FarmteK/BasicAutoSteerPCB/README.md

# BasicAutoSteerPCB

Repository of Eagle schematic and board. Parts list spreadsheet that can be imported into DigiKey's BOM and Cart interface. 

The Eagle files are in v7. Gerber and Drill files made by version 9.1.3

Board is roughly 100mm x 127mm or 4x5 inches.
