FarmteK/BasicAutoSteerPCB/AutoSteerPCB/PartsList.xlsx

Manufacturer Part Number | Manufacturer | Digi-Key Part Number | Customer Reference | Quantity | Unit Price | Extended Price | Description
VX7805-1000 | CUI Inc. | 102-4253-ND |  | 2 | $4.70 | $9.40 | DC DC CONVERTER 5V 5W
15159B | Essentra Components | RPC5587-ND |  | 1 | $1.24 | $1.24 | BLANKING PLUG: .610 IN (15.5 MM)
E1003S.41.10 | General Cable/Carol Brand | CE1003SG-50-ND |  | 1 | $18.35 | $18.35 | CABLE 3COND 22AWG GRAY 50'
1455N1602 | Hammond Manufacturing | HM980-ND |  | 1 | $27.04 | $27.04 | BOX ALUM NATURAL 6.3"LX4.06"W
C320C104J5R5TA7301 | KEMET | 399-9867-1-ND |  | 10 | $0.45 | $4.50 | CAP CER 0.1UF 50V X7R RADIAL
LTL42EKEKNN | Lite-On Inc. | 160-1665-ND |  | 2 | $0.68 | $1.36 | LED RED CLEAR T-1 T/H
M2011LL1W01 | NKK Switches | 360-3287-ND |  | 1 | $7.33 | $7.33 | SWITCH TOGGLE SPST 6A 125V
1N5401RLG | ON Semiconductor | 1N5401RLGOSCT-ND |  | 2 | $0.60 | $1.20 | DIODE GEN PURP 100V 3A DO201AD
1N4004RLG | ON Semiconductor | 1N4004RLGOSCT-ND |  | 4 | $0.28 | $1.12 | DIODE GEN PURP 400V 1A DO41
CB1-P-12V | Panasonic Electric Works | 255-1832-ND |  | 2 | $7.80 | $15.60 | RELAY AUTOMOTIVE SPDT 40A 12V
110-87-306-41-001101 | Preci-Dip | 1212-1002-ND |  | 4 | $0.58 | $2.32 | CONN IC DIP SOCKET 6POS GOLD
35PX1000MEFC10X20 | Rubycon | 1189-1745-ND |  | 4 | $1.04 | $4.16 | CAP ALUM 1000UF 20% 35V RADIAL
108070021 | Seeed Technology Co., Ltd | 1597-1593-ND |  | 1 | $15.26 | $15.26 | MD13S CYTRON 13AMP DC MOTOR DRIV
CF14JT330R | Stackpole Electronics Inc | CF14JT330RCT-ND |  | 15 | $0.06 | $0.90 | RES 330 OHM 1/4W 5% AXIAL
CF14JT1K00 | Stackpole Electronics Inc | CF14JT1K00CT-ND |  | 15 | $0.06 | $0.90 | RES 1K OHM 1/4W 5% AXIAL
5-535541-8 | TE Connectivity AMP Connectors | A32922-ND |  | 1 | $3.26 | $3.26 | CONN RCPT 10POS 0.1 GOLD PCB
5-535541-4 | TE Connectivity AMP Connectors | A32920-ND |  | 1 | $3.06 | $3.06 | CONN RCPT 6POS 0.1 GOLD PCB
1-534237-3 | TE Connectivity AMP Connectors | A26425-ND |  | 2 | $3.79 | $7.58 | CONN RCPT 15POS 0.1 GOLD PCB
282834-3 | TE Connectivity AMP Connectors | A98334-ND |  | 4 | $2.85 | $11.40 | TERM BLK 3P SIDE ENT 2.54MM PCB
282834-4 | TE Connectivity AMP Connectors | A98335-ND |  | 3 | $3.80 | $11.40 | TERM BLK 4P SIDE ENT 2.54MM PCB
282834-7 | TE Connectivity AMP Connectors | A135912-ND |  | 1 | $9.38 | $9.38 | TERM BLK 7P SIDE ENT 2.54MM PCB
282857-3 | TE Connectivity AMP Connectors | A98360-ND |  | 4 | $2.43 | $9.72 | TERM BLK 3P SIDE ENT 5.08MM PCB
282857-2 | TE Connectivity AMP Connectors | A98359-ND |  | 2 | $1.87 | $3.74 | TERM BLK 2P SIDE ENT 5.08MM PCB
4N33 | Vishay Semiconductor Opto Division | 4N33VS-ND |  | 4 | $0.92 | $3.68 | OPTOISO 5.3KV DARL W/BASE 6DIP
61304011121 | Wurth Electronics Inc. | 732-5334-ND |  | 2 | $2.04 | $4.08 | CONN HEADER VERT 40POS 2.54MM
CB1AF-12V | Panasonic Electric Works | 255-2172-ND |  | 1 | $7.29 | $7.29 | RELAY AUTOMOTIVE SPST 40A 12V
VCF4-1000 | TE Connectivity Potter & Brumfield Relays | PB232-ND |  | 1 | $3.38 | $3.38 | RELAY SOCKET 5 POS THROUGH HOLE
Non Digikey Specific
MMA8452Q 3.3V - BOB-13926 | Sparkfun | xx |  | 1 | $8.00 | $8.00 | MMA8452Q Breakout Board
 |  |  |  |  |  |  | https://www.sparkfun.com/products/13926
ADS1115 - 16 bit A/D convertor | AdaFruit, Ebay, Amazon | xx |  | 1 | $12.00 | $12.00 | 16 bit A/D convertor on BO board
 |  |  |  |  |  |  | https://www.adafruit.com/product/1085
Arduino Nano v3 | Arduino (EBAY, Amazon) | xx |  | 1 | $28.50 | $28.50 | ARDUINO NANO ATMEGA328 v3
 |  |  |  |  |  |  | https://www.ebay.ca/i/262445926219?chn=ps&mkevt=1&mkrid=706-89093-2056-0&mkcid=2&dispItem=1
ENC28J60 - Ethernet Module | WorldChips |  |  | 1 | $7.00 | $7.00 | Mini ENC28J60 Webserver module Ethernet Shield board for Arduino Nano v3.0 top
 |  |  |  |  |  |  | https://www.ebay.ca/itm/Mini-ENC28J60-Webserver-module-Ethernet-Shield-board-for-Arduino-Nano-v3-0-top/221629702393
DC Gear Motor - 3269_3 | Phidgets | xx |  |  | $69.00 | $69.00 | 24V/5.1Kg-cm/588RPM 4.25:1 DC Gear Motor
 |  |  |  |  |  |  | https://www.phidgets.com/?&prodid=299
XW-12-24-240W | Various (EBAY) | xx |  |  | $25.00 | $25.00 | 12 v to 24 v convertor - min 10A
 |  |  |  |  |  |  | https://www.ebay.ca/itm/Waterproof-Aluminum-12V-to-24V-DC-DC-Step-Up-Power-Supply-Converter-10A-240W/192404024654
Proximity Switch - LJ12A3-4-Z/BY | Various - (EBAY, Amazon) | xx |  | 1 | $12.00 | $12.00 | Proximity Switch N.O. 4mm
 |  |  |  |  |  |  | https://www.amazon.ca/Detecting-Distance-Inductive-Proximity-LJ12A3-4-Z/dp/B00DUYSWXK
