FarmteK/BasicAutoSteerPCB/RelayAndSwitchPCB/RelaySwitchPCB_Parts.xlsx

Index | Quantity | Part Number | Manufacturer Part Number | Description | Customer Reference | Available | Backorder | Unit Price | Extended Price CAD
1 | 1 | 102-4253-ND | VX7805-1000 | DC DC CONVERTER 5V 5W |  | 1 | 0 | 4.7 | 4.70
2 | 1 | CE1003SG-50-ND | E1003S.41.10 | CABLE 3COND 22AWG GRAY 50' |  | 1 | 0 | 18.35 | 18.35
3 | 10 | 399-9867-1-ND | C320C104J5R5TA7301 | CAP CER 0.1UF 50V X7R RADIAL |  | 10 | 0 | 0.45 | 4.50
4 | 2 | 160-1665-ND | LTL42EKEKNN | LED RED CLEAR T-1 T/H |  | 2 | 0 | 0.68 | 1.36
5 | 2 | 1N5401RLGOSCT-ND | 1N5401RLG | DIODE GEN PURP 100V 3A DO201AD |  | 2 | 0 | 0.6 | 1.20
6 | 2 | 1189-1745-ND | 35PX1000MEFC10X20 | CAP ALUM 1000UF 20% 35V RADIAL |  | 2 | 0 | 1.04 | 2.08
7 | 15 | CF14JT1K00CT-ND | CF14JT1K00 | RES 1K OHM 1/4W 5% AXIAL |  | 15 | 0 | 0.06 | 0.90
8 | 4 | A98335-ND | 282834-4 | TERM BLK 4P SIDE ENT 2.54MM PCB |  | 4 | 0 | 3.8 | 15.20
9 | 3 | A98360-ND | 282857-3 | TERM BLK 3P SIDE ENT 5.08MM PCB |  | 3 | 0 | 2.43 | 7.29
10 | 10 | CF14JT10K0CT-ND | CF14JT10K0 | RES 10K OHM 1/4W 5% AXIAL |  | 10 | 0 | 0.06 | 0.60
11 | 2 | 497-2356-5-ND | ULN2803A | TRANS 8NPN DARL 50V 0.5A 18DIP |  | 2 | 0 | 1.69 | 3.38
12 | 1 | MCP23017-E/SP-ND | MCP23017-E/SP | IC I/O EXPANDER I2C 16B 28SDIP |  | 1 | 0 | 1.87 | 1.87
13 | 2 | AE10918-ND | AR-18-HZL/01-TT | CONN IC DIP SOCKET 18POS GOLD |  | 2 | 0 | 2.01 | 4.02
14 | 1 | AE10029-ND | AR 28 HZL/01/7-TT | CONN IC DIP SOCKET 28POS GOLD |  | 1 | 0 | 3.6 | 3.60
15 | 10 | A98334-ND | 282834-3 | TERM BLK 3P SIDE ENT 2.54MM PCB |  | 10 | 0 | 2.16 | 21.60
16 | 8 | 255-2591-ND | ACT112 | RELAY AUTOMOTIVE SPDT 20A 12V |  | 8 | 0 | 4.26 | 34.08
17 | 10 | CF14JT4K70CT-ND | CF14JT4K70 | RES 4.7K OHM 1/4W 5% AXIAL |  | 10 | 0 | 0.06 | 0.60
