FarmteK/BasicAutoSteerPCB/AutoSteerPCB/diyAutoSteer.brd

## EAGLE design AutoSteerPCB/diyAutoSteer.brd (2019-06-20)

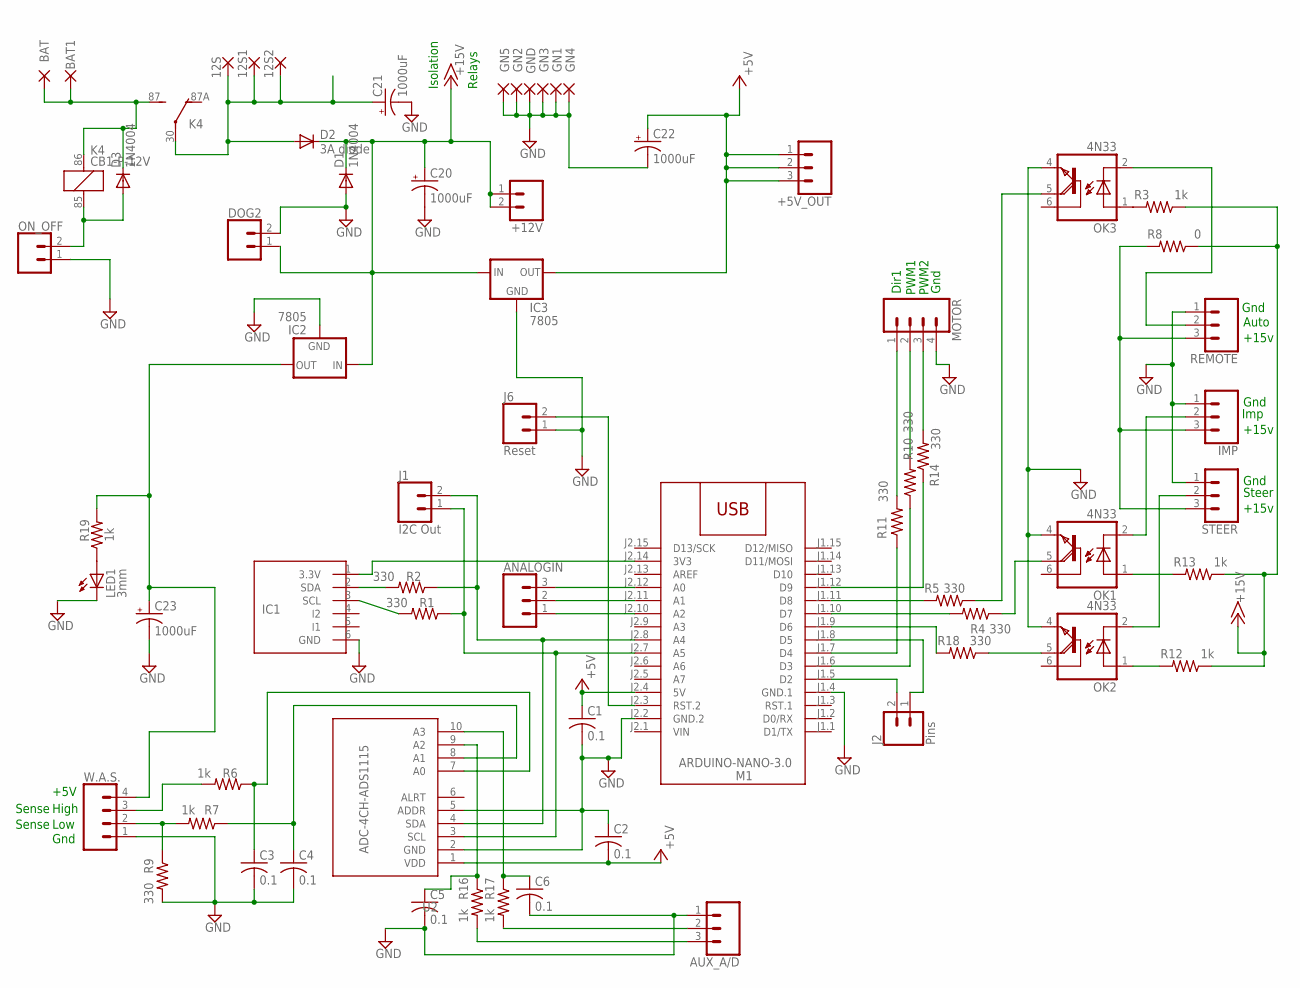
[picture p1: schematic diyAutoSteer.sch]

Parts:
12S, 12S1, 12S2: WIREPAD3,81/1,1; 3,81/1,1
+5V_OUT: CONN_03LONGPADS; 1X03_LONGPADS
+12V: CONN_02PTH3; 1X02_LONGPADS
ANALOGIN: CONN_03LONGPADS; 1X03_LONGPADS
AUX_A/D: CONN_03LONGPADS; 1X03_LONGPADS
BAT, BAT1: WIREPAD3,81/1,1; 3,81/1,1
C1, C2, C3, C4, C5, C6: 0.1; C025-025X050
C20, C21, C22, C23: 1000uF; E5-10,5
D1, D3: 1N4004; DO41-10
D2: 3A diode; DO27-15
DOG2: CONN_02PTH3; 1X02_LONGPADS
GN1, GN2, GN3, GN4, GN5: WIREPAD3,81/1,1; 3,81/1,1
GND: WIREPAD3,81/1,1; 3,81/1,1
IC1: MMA8452Q; BREAKOUT_6PIN
IC2, IC3: 7805; 78XXS
IMP: CONN_03LONGPADS; 1X03_LONGPADS
J1: I2C Out; 1X02_LONGPADS
J2: Pins; 1X02_LONGPADS
J6: Reset; 1X02_LONGPADS
K4: CB1-P-12V; CB1
LED1: 3mm; LED3MM
M1: ARDUINO-NANO-3.0
MOTOR: CONN_04LONGPADS; 1X04_LONGPADS
OK1, OK2, OK3: 4N33; DIL06
ON_OFF: CONN_02PTH3; 1X02_LONGPADS
R1, R2, R4, R5, R9, R10, R11, R14, R18: 330; 0309/12
R3, R6, R7, R12, R13, R16, R17, R19: 1k; 0309/12
R8: 0; 0309/12
REMOTE: CONN_03LONGPADS; 1X03_LONGPADS
STEER: CONN_03LONGPADS; 1X03_LONGPADS
U2: ADC-4CH-ADS1115
W.A.S.: CONN_04LONGPADS; 1X04_LONGPADS

Connections:
+5V: +5V_OUT.1, +5V_OUT.2, +5V_OUT.3, C1.1, C2.2, C22.+, IC3.OUT, M1.J2.4 (5V), U2.1 (VDD)
+15V: +12V.1, +12V.2, C20.+, D1.C, D2.C, DOG2.1, IC2.IN, IC3.IN, R3.1, R8.1, R12.1, R13.1
BATT: BAT.1, BAT1.1, D3.C, K4.86 (1), K4.87 (S)
GND: AUX_A/D.1, C1.2, C2.1, C3.2, C4.2, C5.2, C6.2, C20.-, C21.-, C22.-, C23.-, D1.A, DOG2.2, GN1.1, GN2.1, GN3.1, GN4.1, GN5.1, GND.1, IC1.6 (GND), IC2.GND, IC3.GND, IMP.1, J6.1, LED1.K (C), M1.J1.4 (GND.1), M1.J2.2 (GND.2), MOTOR.4, OK1.4 (E), OK2.4 (E), OK3.4 (E), ON_OFF.1, R9.2, REMOTE.1, STEER.1, U2.2 (GND), U2.5 (ADDR), W.A.S..1
unnamed: IC1.1 (3.3V), M1.J2.14 (3V3)
unnamed: R7.2, R9.1, W.A.S..2
unnamed: IMP.3, R8.2, REMOTE.3, STEER.3
unnamed: M1.J1.6 (D3), R10.1
unnamed: M1.J1.7 (D4), R11.1
unnamed: J2.2, M1.J1.5 (D2)
unnamed: J6.2, M1.J2.3 (RST.2)
unnamed: R6.2, W.A.S..3
unnamed: ANALOGIN.3, M1.J2.12 (A0)
unnamed: M1.J1.12 (D9), R14.1
unnamed: IC1.2 (SDA), R2.2
unnamed: IC1.3 (SCL), R1.2
unnamed: ANALOGIN.2, M1.J2.11 (A1)
unnamed: ANALOGIN.1, M1.J2.10 (A2)
unnamed: LED1.A, R19.1
unnamed: MOTOR.2, R10.2
unnamed: J2.1, M1.J1.8 (D5)
unnamed: MOTOR.1, R11.2
unnamed: C3.1, R6.1, U2.7 (A0)
unnamed: MOTOR.3, R14.2
unnamed: OK2.2 (C), STEER.2
unnamed: M1.J1.11 (D8), R5.2
unnamed: D3.A, K4.85 (2), ON_OFF.2
unnamed: OK2.1 (A), R12.2
unnamed: OK3.1 (A), R3.2
unnamed: M1.J1.10 (D7), R4.2
unnamed: OK3.2 (C), REMOTE.2
unnamed: IMP.2, OK1.2 (C)
unnamed: M1.J1.9 (D6), R18.2
unnamed: OK1.1 (A), R13.2
unnamed: OK3.5 (COL), R5.1
unnamed: C6.1, R17.1, U2.10 (A3)
unnamed: C5.1, R16.1, U2.9 (A2)
unnamed: OK1.5 (COL), R4.1
unnamed: AUX_A/D.2, R17.2
unnamed: OK2.5 (COL), R18.1
unnamed: C4.1, R7.1, U2.8 (A1)
unnamed: AUX_A/D.3, R16.2
SCL: J1.1, M1.J2.7 (A5), R1.1, U2.3 (SCL)
SDA: J1.2, M1.J2.8 (A4), R2.1, U2.4 (SDA)
SW_RAW: 12S.1, 12S1.1, 12S2.1, C21.+, D2.A, K4.30
V+WAS: C23.+, IC2.OUT, R19.2, W.A.S..4
VIN: M1.J2.1 (VIN)

Notes on the sheet:
Gnd
Low
High
+5V
PWM1
PWM2
Dir1
Steer
Imp
Sense
Auto
Isolation
Relays
+15v

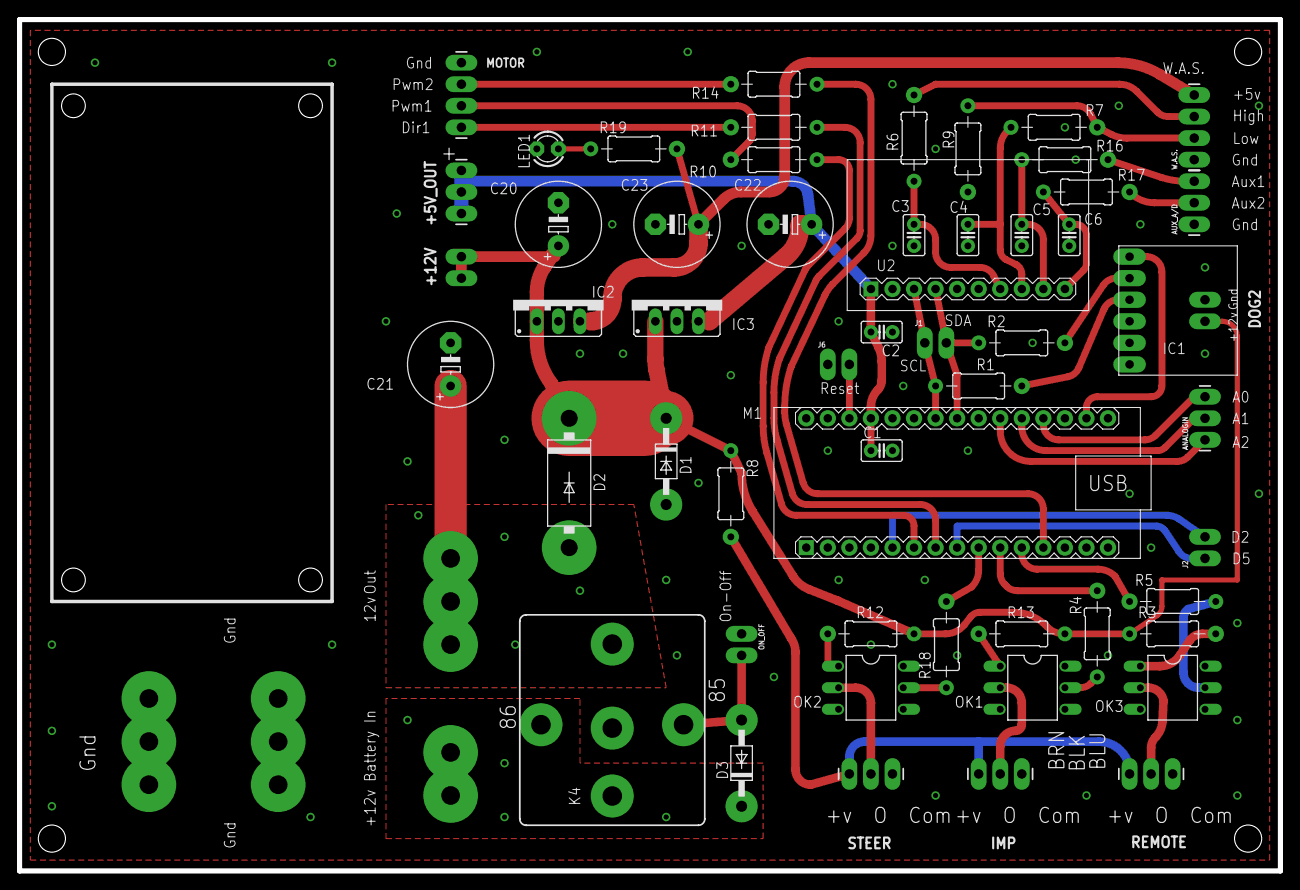
[picture p2: board diyAutoSteer.brd from above]

Board: 2 copper layers, 148.6 x 100.3 mm, 66 parts (0 on the bottom side), 46 nets.
