FarmteK/BasicAutoSteerPCB/RelayAndSwitchPCB/Section.brd

## EAGLE design RelayAndSwitchPCB/Section.brd (2019-03-19)

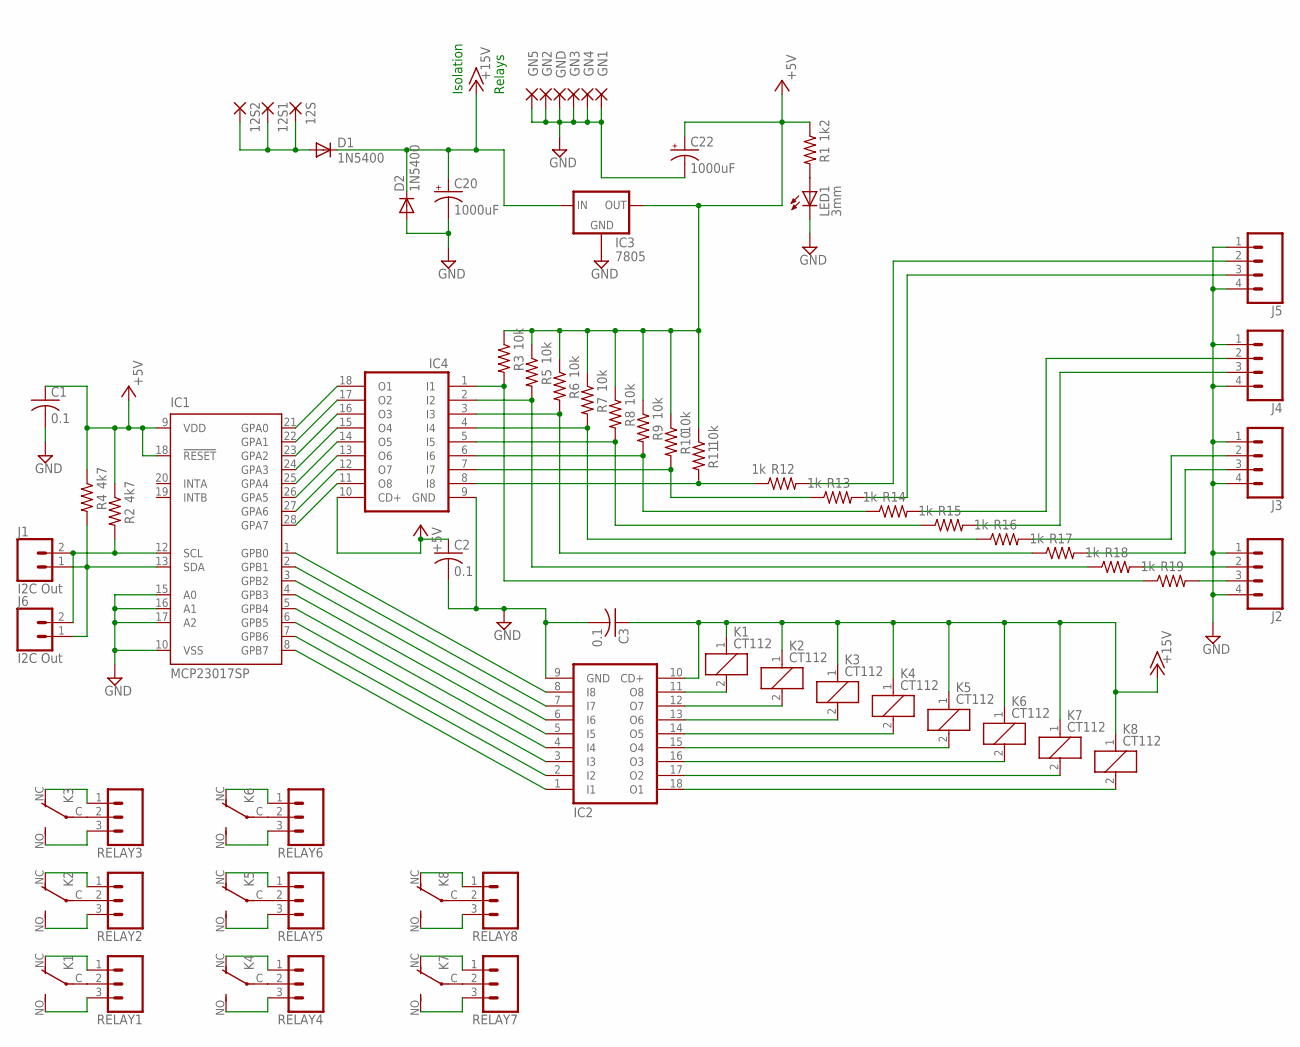
[picture p3: schematic Section.sch]

Parts:
12S, 12S1, 12S2: WIREPAD3,81/1,1; 3,81/1,1
C1, C2, C3: 0.1; C025-025X050
C20, C22: 1000uF; E5-10,5
D1, D2: 1N5400; DO201-15
GN1, GN2, GN3, GN4, GN5: WIREPAD3,81/1,1; 3,81/1,1
GND: WIREPAD3,81/1,1; 3,81/1,1
IC1: MCP23017SP; DIL28-3
IC2, IC4: ULN2803A; DIL18
IC3: 7805; 78XXS
J1, J6: I2C Out; 1X02_LONGPADS
J2, J3, J4, J5: CONN_04LONGPADS; 1X04_LONGPADS
K1, K2, K3, K4, K5, K6, K7, K8: CT112; CT-SLIM
LED1: 3mm; LED3MM
R1: 1k2; 0309/12
R2, R4: 4k7; 0309/12
R3, R5, R6, R7, R8, R9, R10, R11: 10k; 0309/12
R12, R13, R14, R15, R16, R17, R18, R19: 1k; 0309/12
RELAY1, RELAY2, RELAY3, RELAY4, RELAY5, RELAY6, RELAY7, RELAY8: CONN_03LONGPADS; 1X03_LONGPADS

Connections:
+5V: C1.1, C2.1, C22.+, IC1.9 (VDD), IC1.18 (!RESET), IC3.OUT, IC4.10 (CD+), R1.1, R2.1, R3.1, R4.1, R5.1, R6.1, R7.1, R8.1, R9.1, R10.1, R11.1
+12SW: 12S.1, 12S1.1, 12S2.1, D1.A
+15V: C3.1, C20.+, D1.C, D2.C, IC2.10 (CD+), IC3.IN, K1.1, K2.1, K3.1, K4.1, K5.1, K6.1, K7.1, K8.1
GND: C1.2, C2.2, C3.2, C20.-, C22.-, D2.A, GN1.1, GN2.1, GN3.1, GN4.1, GN5.1, GND.1, IC1.10 (VSS), IC1.15 (A0), IC1.16 (A1), IC1.17 (A2), IC2.9 (GND), IC3.GND, IC4.9 (GND), J2.1, J2.4, J3.1, J3.4, J4.1, J4.4, J5.1, J5.4, LED1.K (C)
unnamed: IC2.11 (O8), K1.2
unnamed: IC1.1 (GPB0), IC2.8 (I8)
unnamed: IC1.2 (GPB1), IC2.7 (I7)
unnamed: IC1.3 (GPB2), IC2.6 (I6)
unnamed: IC1.4 (GPB3), IC2.5 (I5)
unnamed: IC1.5 (GPB4), IC2.4 (I4)
unnamed: IC1.6 (GPB5), IC2.3 (I3)
unnamed: IC1.7 (GPB6), IC2.2 (I2)
unnamed: IC1.8 (GPB7), IC2.1 (I1)
unnamed: IC2.12 (O7), K2.2
unnamed: IC2.13 (O6), K3.2
unnamed: IC2.14 (O5), K4.2
unnamed: IC2.15 (O4), K5.2
unnamed: IC2.16 (O3), K6.2
unnamed: IC2.17 (O2), K7.2
unnamed: IC2.18 (O1), K8.2
unnamed: IC1.21 (GPA0), IC4.18 (O1)
unnamed: IC1.22 (GPA1), IC4.17 (O2)
unnamed: K1.C, RELAY1.2
unnamed: K2.C, RELAY2.2
unnamed: K3.C, RELAY3.2
unnamed: K5.C, RELAY5.2
unnamed: K4.C, RELAY4.2
unnamed: K6.C, RELAY6.2
unnamed: K7.C, RELAY7.2
unnamed: IC1.23 (GPA2), IC4.16 (O3)
unnamed: K8.C, RELAY8.2
unnamed: IC1.24 (GPA3), IC4.15 (O4)
unnamed: K1.NC (O), RELAY1.1
unnamed: K1.NO (S), RELAY1.3
unnamed: K2.NO (S), RELAY2.3
unnamed: K2.NC (O), RELAY2.1
unnamed: K3.NO (S), RELAY3.3
unnamed: IC1.25 (GPA4), IC4.14 (O5)
unnamed: K3.NC (O), RELAY3.1
unnamed: K6.NC (O), RELAY6.1
unnamed: K6.NO (S), RELAY6.3
unnamed: K5.NC (O), RELAY5.1
unnamed: K5.NO (S), RELAY5.3
unnamed: K4.NC (O), RELAY4.1
unnamed: K4.NO (S), RELAY4.3
unnamed: K7.NO (S), RELAY7.3
unnamed: K7.NC (O), RELAY7.1
unnamed: K8.NO (S), RELAY8.3
unnamed: K8.NC (O), RELAY8.1
unnamed: LED1.A, R1.2
unnamed: IC1.26 (GPA5), IC4.13 (O6)
unnamed: IC1.27 (GPA6), IC4.12 (O7)
unnamed: IC1.28 (GPA7), IC4.11 (O8)
unnamed: IC4.8 (I8), R11.2, R12.1
unnamed: IC4.7 (I7), R10.2, R13.1
unnamed: IC4.6 (I6), R9.2, R14.1
unnamed: IC4.5 (I5), R8.2, R15.1
unnamed: IC4.4 (I4), R7.2, R16.1
unnamed: IC4.3 (I3), R6.2, R17.1
unnamed: IC4.2 (I2), R5.2, R18.1
unnamed: IC4.1 (I1), R3.2, R19.1
unnamed: J2.3, R19.2
unnamed: J2.2, R18.2
unnamed: J3.3, R17.2
unnamed: J3.2, R16.2
unnamed: J4.3, R15.2
unnamed: J4.2, R14.2
unnamed: J5.3, R13.2
unnamed: J5.2, R12.2
SCL: IC1.12 (SCL), J1.2, J6.2, R2.2
SDA: IC1.13 (SDA), J1.1, J6.1, R4.2

Notes on the sheet:
Isolation
Relays

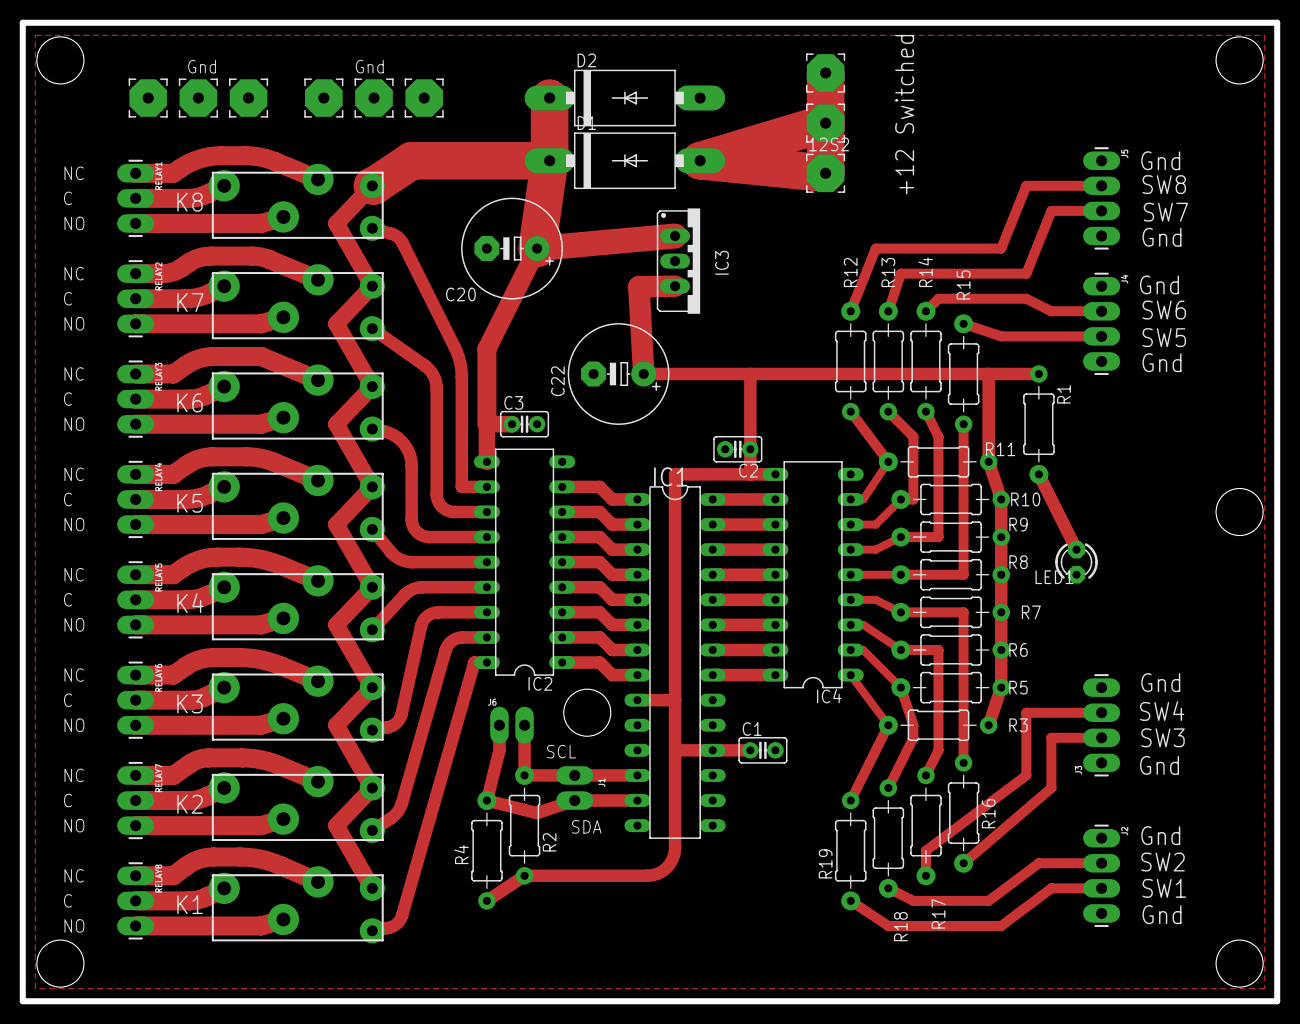
[picture p4: board Section.brd from above]

Board: 2 copper layers, 127.0 x 99.1 mm, 62 parts (0 on the bottom side), 71 nets.
