FarmteK/BasicAutoSteerPCB/(commit log)

2019-03-17 Basic AutoSteer PCB
    Board and parts
    [PartsList.xlsx, diyAutoSteer.brd, diyAutoSteer.sch]
2019-03-19 Create SectionRelayInput.zip
    The section pcb
2019-03-19 Fix Direcory Names
    Separate into 2 directories
    [PartsList.xlsx, Section.brd, Section.sch, diyAutoSteer.brd, diyAutoSteer.sch]
2019-03-20 Added RelayPCB Parts list
    Parts list add
    [RelaySwitchPCB_Parts.xlsx]
2019-04-01 Added ADS1115 to parts
    Missed part, change R8 to zero ohms
    [PartsList.xlsx, diyAutoSteer.brd, diyAutoSteer.sch]
2019-04-18 Added Arduino code
    INO code added
2019-04-29 v2 PCB
    v2 PCB
    [diyAutoSteer.brd, diyAutoSteer.sch]
2019-05-01 Code fixed
    Arduino code fixed with Setup for wrong directions etc
2019-06-20 Version 2
    Version 2 of PCB
    [diyAutoSteer.brd, diyAutoSteer.sch]
